15757170756/Electronic-Design-Competition/README.md

# Electronic-Design-Competition
2015年电子设计竞赛F题 数字频率计的相关程序与文档
