15757170756/Electronic-Design-Competition/(list of files, cad)

Other CAD files:
FPGA/simulation/modelsim/gate_work/@f@p@g@a_@e@p2@c/verilog.psm
FPGA/simulation/modelsim/gate_work/@f@p@g@a_@e@p2@c_vlg_tst/verilog.psm
FPGA/simulation/modelsim/rtl_work/@b@u@f@f/verilog.psm
FPGA/simulation/modelsim/rtl_work/@b@u@f@f_@s@e@n@d_@d@a@t@a/verilog.psm
FPGA/simulation/modelsim/rtl_work/@f@i@f@o2@m@c@u/verilog.psm
FPGA/simulation/modelsim/rtl_work/@f@p@g@a_@e@p2@c_vlg_tst/verilog.psm
FPGA/simulation/modelsim/rtl_work/@s@a@v@e_@a@d@d@r/verilog.psm
FPGA/simulation/modelsim/rtl_work/@s@e@l@e@c@t_@a@d@d@r/verilog.psm
