15757170756/Electronic-Design-Competition/FPGA/simulation/modelsim/rtl_work/@f@i@f@o2@m@c@u/_primary.vhd

library verilog;
use verilog.vl_types.all;
entity FIFO2MCU is
    generic(
        IDLE            : vl_logic_vector(4 downto 0) := (Hi0, Hi0, Hi0, Hi0, Hi0);
        SEND_START      : vl_logic_vector(4 downto 0) := (Hi0, Hi0, Hi0, Hi0, Hi1);
        SEND_ING_1      : vl_logic_vector(4 downto 0) := (Hi0, Hi0, Hi0, Hi1, Hi0);
        SEND_ING_2      : vl_logic_vector(4 downto 0) := (Hi0, Hi0, Hi0, Hi1, Hi1);
        SEND_END        : vl_logic_vector(4 downto 0) := (Hi0, Hi0, Hi1, Hi0, Hi0);
        DELAY_1         : vl_logic_vector(4 downto 0) := (Hi0, Hi0, Hi1, Hi0, Hi1);
        DELAY_2         : vl_logic_vector(4 downto 0) := (Hi0, Hi0, Hi1, Hi1, Hi0)
    );
    port(
        clk             : in     vl_logic;
        rst_n           : in     vl_logic;
        data_in         : in     vl_logic_vector(7 downto 0);
        en              : in     vl_logic;
        len_in          : in     vl_logic_vector(7 downto 0);
        ack             : in     vl_logic;
        clk_out         : out    vl_logic;
        data_out        : out    vl_logic_vector(7 downto 0)
    );
    attribute mti_svvh_generic_type : integer;
    attribute mti_svvh_generic_type of IDLE : constant is 2;
    attribute mti_svvh_generic_type of SEND_START : constant is 2;
    attribute mti_svvh_generic_type of SEND_ING_1 : constant is 2;
    attribute mti_svvh_generic_type of SEND_ING_2 : constant is 2;
    attribute mti_svvh_generic_type of SEND_END : constant is 2;
    attribute mti_svvh_generic_type of DELAY_1 : constant is 2;
    attribute mti_svvh_generic_type of DELAY_2 : constant is 2;
end FIFO2MCU;
