15757170756/Electronic-Design-Competition/FPGA/simulation/modelsim/rtl_work/@s@a@v@e_@a@d@d@r/_primary.vhd

library verilog;
use verilog.vl_types.all;
entity SAVE_ADDR is
    port(
        NADV            : in     vl_logic;
        AD_IN           : in     vl_logic_vector(15 downto 0);
        A16             : in     vl_logic;
        A17             : in     vl_logic;
        A18             : in     vl_logic;
        ADDR            : out    vl_logic_vector(18 downto 0)
    );
end SAVE_ADDR;
